zpukr/esp8266-WindStation/Screenshot_20190304-204054.jpg

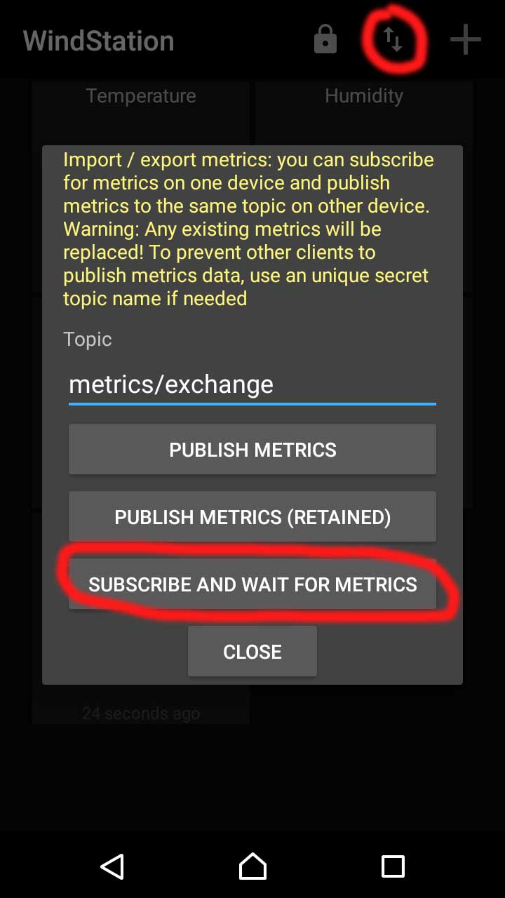
Screenshot_20190304-204054.jpg
