zpukr/esp8266-WindStation/(threads)

Thread 1 (2019-02-07):

Uid does not save

Duyvest, 2019-02-07:
Great Project zpukr - my windgurustation2 stopped working, and for about $5 looks like i can get it back up and running!

Having an issue where the uid does not save during set up - error message is below

> 19:55:02.285 -> http://www.windguru.cz/upload/api.php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
> 19:55:03.013 -> ERROR (unknown station)

after saving the data the serial output shows that it has mounted the file system, and wifi password is saved.

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

running on a nodemcu, and i have changed nothing in your code.  the UID is raglankitebeach, so nothing to special.

Any idea what could be causing this?

Update:

Using the chrome on windows seems to have solved the saving issue.

is there a simple way to calibrate?  Im using a davis anemometer which outputs 1600 pulses an hour for every 1mph in windspeed.

zpukr, 2019-02-16:
Simplest way to calibrate - use MQTT control panel for real time viewing/setup variables. Below, I posted a ready-use template for the MQTT Dash application https://play.google.com/store/apps/details?id=net.routix.mqttdash&hl=uk

`[{"mainTextSize":"LARGE","postfix":" m/s","prefix":"","textColor":-192,"enableIntermediateState":true,"enablePub":false,"enteredIntermediateStateAt":1540661885,"intermediateStateTimeout":10,"jsOnReceive":"","jsonPath":"$.Avr","lastJsonPathValue":"5.62","lastPayload":"{\"Min\": 1.80, \"Avr\": 5.62, \"Max\": 9.90, \"Dir\": 297}","qos":0,"retained":false,"topic":"windpoint/wind","topicPub":"windpoint","updateLastPayloadOnPub":false,"id":"9b0b155b-29c1-48fa-9085-7c54b0f73bbe","jsBlinkExpression":"","jsOnDisplay":"","jsOnTap":"","lastActivity":1540661855,"longId":5,"name":"WindAvr","type":1},{"decimalPrecision":0,"displayPayloadValue":true,"maxValue":360.0,"minValue":0.0,"postfix":"°","prefix":"","progressColor":-192,"enableIntermediateState":true,"enablePub":false,"enteredIntermediateStateAt":1540661885,"intermediateStateTimeout":1,"jsOnReceive":"","jsonPath":"$.Dir","lastJsonPathValue":"297","lastPayload":"{\"Min\": 1.80, \"Avr\": 5.62, \"Max\": 9.90, \"Dir\": 297}","qos":1,"retained":false,"topic":"windpoint/wind","topicPub":"windpoint","updateLastPayloadOnPub":false,"id":"716bae44-f2f5-4ce7-9f79-61292c0d2f2f","jsBlinkExpression":"","jsOnDisplay":"","jsOnTap":"","lastActivity":1540661855,"longId":13,"name":"Direction","type":3},{"mainTextSize":"MEDIUM","postfix":" m/s","prefix":"","textColor":-12550144,"enableIntermediateState":true,"enablePub":false,"enteredIntermediateStateAt":0,"intermediateStateTimeout":0,"jsOnReceive":"","jsonPath":"$.Min","lastJsonPathValue":"1.8","lastPayload":"{\"Min\": 1.80, \"Avr\": 5.62, \"Max\": 9.90, \"Dir\": 297}","qos":0,"retained":false,"topic":"windpoint/wind","topicPub":"sensor","updateLastPayloadOnPub":false,"id":"fd6e2415-bad0-404c-a43b-b164171b8017","jsBlinkExpression":"","jsOnDisplay":"","jsOnTap":"","lastActivity":1540661855,"longId":4,"name":"WindMin","type":1},{"mainTextSize":"MEDIUM","postfix":" m/s","prefix":"","textColor":-65472,"enableIntermediateState":true,"enablePub":false,"enteredIntermediateStateAt":0,"intermediateStateTimeout":0,"jsOnReceive":"","jsonPath":"$.Max","lastJsonPathValue":"9.9","lastPayload":"{\"Min\": 1.80, \"Avr\": 5.62, \"Max\": 9.90, \"Dir\": 297}","qos":0,"retained":false,"topic":"windpoint/wind","topicPub":"sensor","updateLastPayloadOnPub":false,"id":"7eed0deb-cb11-4ec5-ab1f-9ce9305fb341","jsBlinkExpression":"","jsOnDisplay":"","jsOnTap":"","lastActivity":1540661855,"longId":6,"name":"WindMax","type":1},{"mainTextSize":"LARGE","postfix":"°","prefix":"","textColor":-1,"enableIntermediateState":true,"enablePub":false,"enteredIntermediateStateAt":0,"intermediateStateTimeout":0,"jsOnReceive":"","jsonPath":"$.Temp","lastJsonPathValue":"10.0","lastPayload":"{\"Temp\": 10.00, \"Humidity\": 87.00}","qos":0,"retained":false,"topic":"windpoint/temp","topicPub":"sensor","updateLastPayloadOnPub":false,"id":"923e726b-7edd-40dd-ad5d-6831cd6670e0","jsBlinkExpression":"","jsOnDisplay":"","jsOnTap":"","lastActivity":1540661854,"longId":1,"name":"Temperature","type":1},{"mainTextSize":"LARGE","postfix":"%","prefix":"","textColor":-1,"enableIntermediateState":true,"enablePub":false,"enteredIntermediateStateAt":0,"intermediateStateTimeout":0,"jsOnReceive":"","jsonPath":"$.Humidity","lastJsonPathValue":"87.0","lastPayload":"{\"Temp\": 10.00, \"Humidity\": 87.00}","qos":0,"retained":false,"topic":"windpoint/temp","topicPub":"","updateLastPayloadOnPub":true,"id":"4db3b3ca-d9d4-472f-af7c-f8ed3403a0a6","jsBlinkExpression":"","jsOnDisplay":"","jsOnTap":"","lastActivity":1540661854,"longId":7,"name":"Humidity","type":1},{"decimalPrecision":0,"displayPayloadValue":true,"maxValue":140.0,"minValue":20.0,"postfix":"","prefix":"","progressColor":-1,"enableIntermediateState":false,"enablePub":true,"enteredIntermediateStateAt":1540661885,"intermediateStateTimeout":10,"jsOnReceive":"","jsonPath":"","lastPayload":"90","qos":1,"retained":false,"topic":"windpoint/kc_wind","topicPub":"windpoint","updateLastPayloadOnPub":false,"id":"4d50b3f6-8f21-40b9-b90b-17031b769896","jsBlinkExpression":"","jsOnDisplay":"","jsOnTap":"","lastActivity":1540661809,"longId":8,"name":"kcWind","type":3},{"iconOff":"ic_cloud_download","iconOn":"ic_cloud_download","offColor":-1,"onColor":-1,"payloadOff":"sensor","payloadOn":"sensor","enableIntermediateState":true,"enablePub":true,"enteredIntermediateStateAt":0,"intermediateStateTimeout":0,"jsOnReceive":"","jsonPath":"","lastPayload":"sensor","qos":1,"retained":false,"topic":"windpoint","topicPub":"","updateLastPayloadOnPub":true,"id":"df5bfda3-d3b7-4c92-8fe7-a425e20cfd95","jsBlinkExpression":"","jsOnDisplay":"","jsOnTap":"","lastActivity":1540661840,"longId":9,"name":"Update","type":2},{"mainTextSize":"SMALL","postfix":"","prefix":"","textColor":-1,"enableIntermediateState":true,"enablePub":false,"enteredIntermediateStateAt":0,"intermediateStateTimeout":0,"jsOnReceive":"","jsonPath":"","lastPayload":"ADC:781","qos":1,"retained":false,"topic":"windpoint/debug","topicPub":"","updateLastPayloadOnPub":true,"id":"d8222a02-352e-48d0-b466-b78e9a382a19","jsBlinkExpression":"","jsOnDisplay":"","jsOnTap":"","lastActivity":1540661885,"longId":11,"name":"Debug","type":1},{"iconOff":"ic_explore","iconOn":"ic_explore","offColor":-1,"onColor":-1,"payloadOff":"adc","payloadOn":"adc","enableIntermediateState":false,"enablePub":true,"enteredIntermediateStateAt":0,"intermediateStateTimeout":0,"jsOnReceive":"","jsonPath":"","lastPayload":"adc","qos":1,"retained":false,"topic":"windpoint","topicPub":"","updateLastPayloadOnPub":true,"id":"cf88116a-4130-45bc-b77f-f6a0895b5548","jsBlinkExpression":"","jsOnDisplay":"","jsOnTap":"","lastActivity":1540661885,"longId":12,"name":"Read ADC","type":2},{"iconOff":"ic_flash_on","iconOn":"ic_flash_on","offColor":-1,"onColor":-1,"payloadOff":"reset","payloadOn":"reset","enableIntermediateState":true,"enablePub":true,"enteredIntermediateStateAt":0,"intermediateStateTimeout":0,"jsOnReceive":"","jsonPath":"","lastPayload":"reset","qos":1,"retained":false,"topic":"windpoint","topicPub":"","updateLastPayloadOnPub":true,"id":"aabe562f-5790-4d2a-ae3b-60526dfd4621","jsBlinkExpression":"","jsOnDisplay":"","jsOnTap":"","lastActivity":1540372437,"longId":10,"name":"Reset!","type":2}]`

zpukr, 2019-02-16:
MQTT Dash screenshot:
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

Closed 2019-02-24.

Thread 2 (2019-02-24):

Not wifi conection

odnanref25, 2019-02-24:
Hi, first of all, thanks a lot for your project :)

I have compiled ".ino" in my esp8266 and I can't see "WindStationAP" wifi. I have all the libraries installed and the complilation goes well but when the compilation is finish i look for new wifi account with my mobile phone and nothing new.

This is my first Arduino project :P

odnanref25, 2019-02-24:
Ok, I have solved this problem, I was using the wrong board!! For the Wemos D1 mini the right board seems to be "LOLIN (Wemos) D1 R2 & mini.

zpukr, 2019-02-24:
The project is guaranteed to work on any ESP8266 ESP-12E / ESP-12F (wemos, witty cloud, nodemcu etc) board. I think so at least :)

Closed 2019-02-24.

Thread 4 (2019-05-30):

Pull up/ doen resistor on windspeed

Duyvest, 2019-05-30:
Hi,

Do you think a pull up resistor is necessary on the wind pin?  I sometime get some high windspeed or 0 windspeed readings very randomly.  I am going to add this today to see if it helps.

I also i added some debounce to the wind speed measurements which shouldhelp with switch debounce.

`
void windcount() {
    if((long)(micros() - last_micros) >= debouncing_time * 1000) {
    windimpulse++;
    last_micros = micros();
    digitalWrite(LED, !digitalRead(LED));
    }
}
`

zpukr, 2019-06-05:
You must check voltage level on wind pin at first. Set voltmeter on wind pin and slowly rotate anemometer by hand. Voltage must have only two values: first - close to 0V, second close to 3.3V. May be you realy  need pull up resistor to VCC or GND, depend from result of measurement

Closed 2019-06-07.

Thread 5 (2019-06-20):

Value for kc_wind?

brian-naylor, 2019-06-20:
Hello,
Thanks for sharing your code, which looks great and works well.
However, I am seeing very large wind readings, far above other readings locally.   What values are you using for the kc_wind to adjust its calibration for the Davis 6410?

eg.
windimpulse: 12 millis: 3001     7.82 knots
windimpulse:11 millis: 3001      7.17 knots
windimpulse: 9 millis: 3001      5.86  etc

ricka75, 2019-06-24:
Hi, need to put 4.7k  resistor between power and wind speed to avoid misreadings. http://cactus.io/hookups/weather/anemometer/davis/hookup-arduino-to-davis-anemometer
https://www.youtube.com/watch?v=wxjerCHCEMg

ricka75, 2019-06-25:
I would first check if pullup resistor needed between VCC and Pin. I had the same issue with abnormal readings.

zpukr, 2019-06-29:
I don't know sharp value of kc_wind for you case. You can use any value from 1 to 999. If for kc_wind=1 wind still very large you can modife row:
`windMS = (float) windimpulse * windPeriodSec*1000 /(millis() - secTTasks) *atoi(kc_wind)/100;`
to
`windMS = (float) windimpulse * windPeriodSec*1000 /(millis() - secTTasks) *atoi(kc_wind)/1000;`

Closed 2019-06-29.

Thread 6 (2020-07-15):

TX20 instead TX23

javier6d2, 2020-07-15:
Good morning,

I have an old La Crosse TX20 working with Tasmota firmaware, I would like test your firmware to upload data to Windguru. TX20 and TX23 differ only in the protocol used, but deliver the same measured values. Do you think TX20 is compatible with your firmware?

Kind regards.

elucastech, 2020-09-04:
Hi!
I have the same problem; I found an old working Technoline TX20 and I would like to use it with your firmware. Is it compatible?

Thanks in advance.

gh4chris, 2020-12-27:
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

To my understanding the sensors got nothing to do with the coding. They just provide the telemetric data to the circuit where it is read by the software and processed.

By the way, I'd recommend not to mentions the old LaCrosse any more, but to point to the newer model that can be ordererd:
https://www.lacrossetechnology.com/products/ltv-wsdth01

blachz, 2022-09-02:
yes, sensors just send electric signals to the board.
The newer model you mentionned is wireless, there is no way to use it on ESP8266 inputs

Thread 8 (2020-12-27):

LaCrosse LTV-WSDTH01 Breeze Pro Sensor

gh4chris, 2020-12-27:
LaCrosse has the following model with solar panel on sale
https://www.lacrossetechnology.com/products/ltv-wsdth01

It is the LTV-WSDTH01 Breeze Pro Sensor

The TX can't be found on the market any longer, it's out of stock

blachz, 2022-09-02:
This device is wireless, no way to use it on ESP8266 Pins

Thread 9 (2021-01-08):

Ambient Weather WS-1080 sensors.

elucastech, 2021-01-08:
Hi, has anyone tried using the WS-1080 Ambient Weather sensors with this project? I am having errors in the detection of the cardinal points; some are out of phase by 90 ° others by 180 ° and I cannot solve.

elucastech, 2021-02-17:
Solved!

Closed 2021-02-17.

Thread 10 (2021-07-08):

Issue with the compilation

Foinard, 2021-07-08:
I downloaded the library ArduinoJson and WiFiManager but still encountered many problems with the compilation
First thing first
"byte is too ambiguous" or "undef"
I tried to put <Arduino.h>
or the command typedef uint8_t byte;
And it still doesn't work
Also "mqtt_server isn't defined do you mean mqtt_user ?"
I recommand you to try the program by yourself after downloading these both libraries
If anyone know what should I do thank you in advance

Foinard, 2021-08-14:
By quickly making researches on the internet
I found out that this might be linked to a recent update
The file is two years old maybe this is linked

Foinard, 2021-08-14:
Some commands aren’t defined correctly and when I try to define them with what I found on the internet it recreates some compilation problems because the program itself is working with those definitions im lost…

Foinard, 2022-01-16:
Okay so I made quite a long time figuring out where was the issue
Firstly you have to download ArduinoJson in the library manager
And more importantly, you have to download the version 2.7.4 of esp 8266 in the board manager ( the newer versions won't work )

Closed 2022-01-16.
