zpukr/esp8266-WindStation/NtpClientLib.h

#define _NtpClientLib_h
#ifdef ESP8266
#include <functional>
using namespace std;
using namespace placeholders;
#endif
#include "TimeLib.h"
#if defined(ARDUINO) && ARDUINO >= 100
#include "Arduino.h"
#else
#include "WProgram.h"
#endif
#define NETWORK_W5100           (1) // Arduino Ethernet Shield
#define NETWORK_ENC28J60        (2) // Alternate Ethernet Shield
#define NETWORK_WIFI101			(3) // WiFi Shield 101 or MKR1000
#define NETWORK_ESP8266			(100) // ESP8266 boards, not for Arduino using AT firmware
#define NETWORK_ESP32           (101) // ESP32 boards
#define DEFAULT_NTP_SERVER "pool.ntp.org" // Default international NTP server. I recommend you to select a closer server to get better accuracy
#define DEFAULT_NTP_PORT 123 // Default local udp port. Select a different one if neccesary (usually not needed)
#define NTP_TIMEOUT 1500 // Response timeout for NTP requests
#define DEFAULT_NTP_INTERVAL 1800 // Default sync interval 30 minutes
#define DEFAULT_NTP_SHORTINTERVAL 15 // Sync interval when sync has not been achieved. 15 seconds
#define DEFAULT_NTP_TIMEZONE 0 // Select your local time offset. 0 if UTC time has to be used
const int NTP_PACKET_SIZE = 48; // NTP time is in the first 48 bytes of message
#ifdef ARDUINO_ARCH_ESP8266
#define NETWORK_TYPE NETWORK_ESP8266
#elif defined ARDUINO_ARCH_SAMD || defined ARDUINO_ARCH_ARC32
#define NETWORK_TYPE NETWORK_WIFI101 // SET YOUR NETWORK INTERFACE
#elif defined ARDUINO_ARCH_AVR
#define NETWORK_TYPE NETWORK_W5100
#elif defined ARDUINO_ARCH_ESP32 || defined ESP32
#define NETWORK_TYPE NETWORK_ESP32
#endif
#if NETWORK_TYPE == NETWORK_W5100
#include <EthernetUdp.h>
#include <Ethernet.h>
#elif NETWORK_TYPE == NETWORK_WIFI101
#include <WiFiClient.h>
#include <WiFiUdp.h>
#include <WiFi101.h>
#elif NETWORK_TYPE == NETWORK_ESP8266
#include <ESP8266WiFi.h>
#include <WiFiUdp.h>
#include <Udp.h>
#elif NETWORK_TYPE == NETWORK_ESP32
#include <WiFi.h>
#include <WiFiUdp.h>
#include <Udp.h>
#else
#error "Incorrect platform. Only ARDUINO and ESP8266 MCUs are valid."
#endif // NETWORK_TYPE
typedef enum {
    timeSyncd, // Time successfully got from NTP server
    noResponse, // No response from server
    invalidAddress // Address not reachable
} NTPSyncEvent_t;
#if defined ARDUINO_ARCH_ESP8266 || defined ARDUINO_ARCH_ESP32
#include <functional>
typedef std::function<void (NTPSyncEvent_t)> onSyncEvent_t;
#else
typedef void (*onSyncEvent_t)(NTPSyncEvent_t);
#endif
class NTPClient {
public:
    NTPClient ();
#if NETWORK_TYPE == NETWORK_W5100
    bool begin (String ntpServerName = DEFAULT_NTP_SERVER, int8_t timeOffset = DEFAULT_NTP_TIMEZONE, bool daylight = false, int8_t minutes = 0, EthernetUDP* udp_conn = NULL);
#elif NETWORK_TYPE == NETWORK_ESP8266 || NETWORK_TYPE == NETWORK_WIFI101 || NETWORK_TYPE == NETWORK_ESP32
    bool begin (String ntpServerName = DEFAULT_NTP_SERVER, int8_t timeOffset = DEFAULT_NTP_TIMEZONE, bool daylight = false, int8_t minutes = 0, WiFiUDP* udp_conn = NULL);
#endif
    bool setNtpServerName (String ntpServerName);
    bool setNtpServerName (char* ntpServerName);
    bool setNtpServerName (String ntpServerName, int idx) {
        if (idx < 0 || idx > 2)
            return false;
        return setNtpServerName (ntpServerName);
    }
    String getNtpServerName ();
    char* getNtpServerNamePtr ();
    String getNtpServerName (int idx) {
        if (idx < 0 || idx > 2)
            return "";
        return getNtpServerName ();
    }
    time_t getTime ();
    bool setTimeZone (int8_t timeZone, int8_t minutes = 0);
    int8_t getTimeZone ();
    int8_t getTimeZoneMinutes ();
    bool stop ();
    bool setInterval (int interval);
    bool setInterval (int shortInterval, int longInterval);
    int getInterval ();
    int	getShortInterval ();
    int	getLongInterval () { return getInterval (); }
    void setDayLight (bool daylight);
    bool getDayLight ();
    String getTimeStr () { return getTimeStr (now ()); }
    String getTimeStr (time_t moment);
    String getDateStr () { return getDateStr (now ()); }
    String getDateStr (time_t moment);
    String getTimeDateString () { return getTimeDateString (now ()); }
    String getTimeDateString (time_t moment);
    time_t getLastNTPSync ();
    String getUptimeString ();
    time_t getUptime ();
    time_t getLastBootTime ();
    time_t getFirstSync ();
    void onNTPSyncEvent (onSyncEvent_t handler);
    boolean isSummerTime () {
        if (_daylight)
            return isSummerTimePeriod (now ());
        else
            return false;
    }
    boolean isSummerTimePeriod (time_t moment);
protected:
#if NETWORK_TYPE == NETWORK_W5100
    EthernetUDP *udp;
#elif NETWORK_TYPE == NETWORK_ESP8266 || NETWORK_TYPE == NETWORK_WIFI101 || NETWORK_TYPE == NETWORK_ESP32
    WiFiUDP *udp;
#endif
    bool _daylight;             ///< Does this time zone have daylight saving?
    int8_t _timeZone = 0;       ///< Keep track of set time zone offset
    int8_t _minutesOffset = 0;   ///< Minutes offset for time zones with decimal numbers
    char* _ntpServerName;       ///< Name of NTP server on Internet or LAN
    int _shortInterval;         ///< Interval to set periodic time sync until first synchronization.
    int _longInterval;          ///< Interval to set periodic time sync
    time_t _lastSyncd = 0;      ///< Stored time of last successful sync
    time_t _firstSync = 0;      ///< Stored time of first successful sync after boot
    unsigned long _uptime = 0;  ///< Time since boot
    onSyncEvent_t onSyncEvent;  ///< Event handler callback
    static time_t s_getTime ();
    bool summertime (int year, byte month, byte day, byte hour, byte tzHours);
public:
    time_t decodeNtpMessage (char *messageBuffer);
    void setLastNTPSync (time_t moment);
private:
};
extern NTPClient NTP;
