zpukr/esp8266-WindStation/(commit log)

2019-07-09 v1.3
    Add customizable switch debounce, tnx for Duyvest and minor changes
2019-09-14 Update esp8266-WindStation.ino
    Migrating ArduinoJson from version 5 to 6
