zpukr/esp8266-WindStation/(notices)

Notices in the files:
NtpClientLib.h:
Copyright 2016 German Martin (gmag11@gmail.com). All rights reserved.
